qyugo/YVGESC/docs/hardware/README.md

---
title: Hardware Design
nav_order: 3
has_children: true
---

## Hardware Design

Here lies the documentation for the board design, including schematics, component datasheets, bill of materials, and the documentation of my design process.
