qyugo/YVGESC/docs/hardware/schematic.md

---
title: Schematics
parent: Hardware Design
nav_order: 2
---

# KiCad Schematic

---

YVGESC-1 was designed in KiCad.

<iframe src="https://qyugo.github.io/YVGESC/docs/images/yvgesc1-schematic2.pdf" width="100%" height="800px" style="border: none;"></iframe>

Click [here](https://qyugo.github.io/YVGESC/docs/images/yvgesc1-schematic2.pdf) to download as a PDF.

# PCB Routing

---

Here are some images of the PCB layout. Feel free to email me for more detailed views/project files.

<iframe src="https://qyugo.github.io/YVGESC/docs/images/pcbdesign.pdf" width="100%" height="800px" style="border: none;"></iframe>
