qyugo/YVGESC/firmware/yvgesc-1p0config.md

---
title: 1.0 Firmware Documentation
parent: Firmware
nav_order: 1
---

*UNDER CONSTRUCTION, Please come back later for updates and better organization. 10/14/26*

# Documentation for 0.0 Firmware to 1.0 Firmware

This documents the hardware, firmware, and software bring-up and testing process for developing all V0 versions up to V1.0, which is the first stable release.

## 1. Blink, Clock Config (V0.0)

1. Blink test on PB11 (33), toggle 2000ms

Configures PB11 (33) as blink GPIO for 0-3.3V oscillation of 2000ms, for verifying clock configuration. 

Initial testing firmware is configured in STM32CubeMX. STM32CubeMX was used to generate an STM32CubeIDE project for blink.

Here is a quick setup for flashing a 0-3.3v blink on the PB11 pin measured via oscilloscope.

From the Pinout and Configuration tab on the home page, switch to System View and configure the following:

SYS: Debug -> Serial Wire





The oscillator that this board uses is an Abracon AB8MG. From the Clock tab, set input frequency to 8MHz, and HSE at System Clock Mux and PLL Source Mux.



Timer toggle:





## 2. AS5047P Encoder

CubeMX was used to generate a CMake project for the rest of the v1p0 firmware.

The encoder is wired in at SPI2 (PB12, 13, 14, 25) for CSN, CLK, MOSI, and MISO

I wired PB14 to MOSI and PB15 to MISO mistakenly, so this will be changed if there is a V2 version of the board.

i. Instead of full duplex master, PB14->MOSI will need to be a permanently high GPIO and SPI2 will be configured in Half Duplex Master mode.

ii. Additionally, PB12 (ENC_CS) is set to HIGH GPIO. With NSS disabled, the pinout should show ENC_CS instead of SPI2_NSS.

iii. AS5047P encoders deliver 16 bits per frame and runs on a 2-Edge clock phase, so the setting must match accordingly.





SPI2 is effectively only configured to receive. The functions ```HAL_SPI_Transmit``` and ```HAL_SPI_TransmitReceive``` therefore, should never be called.

## 3. Gate Driver

1. DRV_Enable

The MCU on the YVGESC maps PC0 (8) to DRV_ENABLE. In Pinout view, this is set to GPIO output, ensuring output level: LOW in System Core -> GPIO.



2. DRV_nFAULT is set to PA6 in hardware, so it is configured to GPIO input in CubeMX:



This is where I encountered the first issue, as ADC was not properly reading the nFAULT signals. This is later fixed via hardware and in the 

Correction (unused): Led and fault, 100k resistor for v2

Notes: PA6 to ADC2_IN3 Watchdog
VREFINT Debug



SOC and Solder

VREF Soldered to 3.3V (issue 3, bringup for yvgesc v2)
SOC multimeter/scope checks

## 4. Current Sense







I had Vrefint wrongly configured. Update with CAL_ON = 1:



...and CAL_ON=0:



There is some noise, may try to reduce using oversampling later on, there is likely some noise nearby due to all the soldering or otherwise.

Current sense complete, next up will be the FDCAN and first PWM drive.

ADC and everything works. Released as 0.1.

## 5. FDCAN

PB8 is wired to CAN_RX, and PB9 is wired to CAN_TX, clocked to HSE @ 8MHz.



Test 1: internal loopback, 500kbits/s, sample point 87.5%



Will test Normal mode with another can bus to test for receiving messages as well as the termination switch.

## 6. PWM + Open Loop

Pinout:
INHA: PA8
INLA: PA7
INHB: PA9
INLB: PB0
INHC: PA10
INLC: PB1



Center aligned, 20kHz, 500ns dead time (currently x4)

Works.

CLock to PLL, 8-170MHz

pllm to /2



124ns tim1 dead time

SPi2 prescaler to 5.3125 mHZ

Open loop success. Released as 0.2.

## 7. Phase Current Sampling for FOC Loops

In this part, the sampling is configured to happen at a fixed point in each PWM cycle. The shunts are located on the low side FETs.

A PWM generation (No Output) channel is set for CH4, acting basically as a comparator:


VREF, initially part of the 4 injected channels, is now in the regular conversion channel. 



For the injected conversions, the sample is now performed on the falling edge of Timer 1 Trigger Out Event 2.

The interrupt line in USER CODE 4 is implemented as follows:

```
c
void HAL_ADCEx_InjectedConvCpltCallback(ADC_HandleTypeDef *h)
{
    if (h->Instance != ADC1) return;
    int32_t a = HAL_ADCEx_InjectedGetValue(h, ADC_INJECTED_RANK_1);
    int32_t b = HAL_ADCEx_InjectedGetValue(h, ADC_INJECTED_RANK_2);
    int32_t c = HAL_ADCEx_InjectedGetValue(h, ADC_INJECTED_RANK_3);
    so[0] = a; so[1] = b; so[2] = c;

    static int32_t sa, sb, sc, n;                 /* offset calibration */
    if (cal_req && !pwm_run) {
        sa += a; sb += b; sc += c;
        if (++n == 1024) {
            off[0] = sa / 1024; off[1] = sb / 1024; off[2] = sc / 1024;
            sa = sb = sc = n = 0; cal_req = 0;
        }
    }
    ia = (a - off[0]) * A_PER_COUNT;
    ib = (b - off[1]) * A_PER_COUNT;
    ic = (c - off[2]) * A_PER_COUNT;
    isum = ia + ib + ic;
    isr_cnt++;
}
```

Calibrating (cal_req=1, pwm_on=1, ol_mode=1, ol_v = 0.12



Current sums roughly 0:



Calibration with encoder adn offset:











ia, ib, ic are amps of the measured phase currents by the ADC via its $1 m\Omega$ shunt and multiplied by the gain of 40V/V.

Contextualization
Next, ia, ib, and ic are used in the Clarke transforms to become $I\alpha$ and $I\beta$, into a 2-part current descriptor in reference to the stator frame.

The park transform then converts $I\alpha$ and $I\beta$ into Iq and Id, in reference to the rotor axis.

The current loop then keeps Id at 0 and Iq relative to a torque command.

## 8. CURRENT LOOP - Running inside the ADC2 interrupt (20kHz)

What it does: measures current and transforms them into Id and Iq using encoder angle, with two PI controllers

New variables:
```
c
volatile uint32_t foc_mode = 0;          /* 1 = current loop drives the PWM */
volatile float id_ref = 0.0f, iq_ref = 0.0f;   /* commanded currents, A */
volatile float id, iq, vd, vq;           /* measured currents, output voltages */
volatile float kp = 0.3f;                /* V/A   (L × ωc, ωc = 2π·1 kHz) */
volatile float ki_ts = 0.03f;            /* V/A per sample (R × ωc × Ts) */
volatile float i_max = 2.0f;             /* command limit, A */
volatile float i_trip = 8.0f;            /* instant shutdown, A */
volatile uint32_t foc_fault = 0, isr_cycles = 0;
#define VBUS 12.0f
```

Interrupt callback:
```
c
void HAL_ADCEx_InjectedConvCpltCallback(ADC_HandleTypeDef *h)
{
    if (h->Instance != ADC1) return;
    uint32_t t0 = DWT->CYCCNT;

    /* --- currents --- */
    int32_t a = HAL_ADCEx_InjectedGetValue(h, ADC_INJECTED_RANK_1);
    int32_t b = HAL_ADCEx_InjectedGetValue(h, ADC_INJECTED_RANK_2);
    int32_t c = HAL_ADCEx_InjectedGetValue(h, ADC_INJECTED_RANK_3);
    so[0] = a; so[1] = b; so[2] = c;

    static int32_t sa, sb, sc, n;
    if (cal_req && pwm_run && ol_mode && !foc_mode && ol_v == 0.0f) {
        sa += a; sb += b; sc += c;
        if (++n == 1024) {
            off[0] = sa / 1024; off[1] = sb / 1024; off[2] = sc / 1024;
            sa = sb = sc = n = 0; cal_req = 0;
        }
    }
    ia = (a - off[0]) * A_PER_COUNT;
    ib = (b - off[1]) * A_PER_COUNT;
    ic = (c - off[2]) * A_PER_COUNT;
    isum = ia + ib + ic;

    /* --- encoder (moved here from the main loop) --- */
    raw = enc_frame();
    reads++;
    if (__builtin_parity(raw))      par_err++;
    else if (raw & 0x4000)          ef_cnt++;
    else                            ang = raw & 0x3FFF;
    float mech  = ang * (360.0f / 16384.0f);
    float raw_e = fmodf(mech * pole_pairs, 360.0f);
    if (align_req && pwm_run) { e_off = raw_e; align_req = 0; }
    e_deg = raw_e - e_off;
    if (e_deg < 0.0f) e_deg += 360.0f;

    /* --- hard overcurrent trip --- */
    if (fabsf(ia) > i_trip || fabsf(ib) > i_trip || fabsf(ic) > i_trip) {
        __HAL_TIM_MOE_DISABLE_UNCONDITIONALLY(&htim1);
        pwm_run = 0; foc_fault = 1;
    }

    /* --- current loop --- */
    static float id_int = 0.0f, iq_int = 0.0f;
    if (foc_mode && pwm_run) {
        float th = e_deg * 0.0174533f, s = sinf(th), co = cosf(th);

        float ial = ia;                              /* Clarke */
        float ibe = (ia + 2.0f * ib) * 0.57735f;
        id =  ial * co + ibe * s;                    /* Park */
        iq = -ial * s  + ibe * co;

        float idr = fminf(fmaxf(id_ref, -i_max), i_max);
        float iqr = fminf(fmaxf(iq_ref, -i_max), i_max);
        float vlim = 0.9f * VBUS * 0.57735f;

        float ed = idr - id, eq = iqr - iq;          /* PI */
        id_int = fminf(fmaxf(id_int + ki_ts * ed, -vlim), vlim);
        iq_int = fminf(fmaxf(iq_int + ki_ts * eq, -vlim), vlim);
        float vdd = kp * ed + id_int, vqq = kp * eq + iq_int;
        float vm = sqrtf(vdd * vdd + vqq * vqq);
        if (vm > vlim) { vdd *= vlim / vm; vqq *= vlim / vm; }
        vd = vdd; vq = vqq;

        float val = vdd * co - vqq * s;              /* inverse Park */
        float vbe = vdd * s  + vqq * co;
        float Va = val;                              /* inverse Clarke */
        float Vb = -0.5f * val + 0.866025f * vbe;
        float Vc = -0.5f * val - 0.866025f * vbe;
        float vo = 0.5f * (fmaxf(Va, fmaxf(Vb, Vc)) + fminf(Va, fminf(Vb, Vc)));

        uint32_t arr = __HAL_TIM_GET_AUTORELOAD(&htim1);
        float k = arr / VBUS, mid = arr * 0.5f;
        __HAL_TIM_SET_COMPARE(&htim1, TIM_CHANNEL_1, (uint32_t)(mid + (Va - vo) * k));
        __HAL_TIM_SET_COMPARE(&htim1, TIM_CHANNEL_2, (uint32_t)(mid + (Vb - vo) * k));
        __HAL_TIM_SET_COMPARE(&htim1, TIM_CHANNEL_3, (uint32_t)(mid + (Vc - vo) * k));
    } else {
        id_int = iq_int = 0.0f;                      /* reset when not running */
    }

    isr_cycles = DWT->CYCCNT - t0;
    isr_cnt++;
}
```

Testing order:
foc_mode = 0, ol_mode = 1, ol_v = 0, cal_req = 1, pwm_on = 1

ol_v = 0.15, ol_deg = 0, -> run -> align_req = 1

## 9. TORQUE MODE/closed loop current, and calibration script 

Minimum Iq = 2 to spin for Eaglepower

Torque mode / inner PI loops complete

Self note: kp = 0.3, ki = 0.03

FLASH update to store calibrations:
```c FLASH    (rx)    : ORIGIN = 0x8000000,   LENGTH = 126K ```

AFter good alignment: save_req = 1, save_res = 0 in debug

Works with flash calibration. If needed, realign and hit save_req=1, otherwise calibration should happen automatically upon boot.

## 10. VELOCITY CONTROL

Interrupt:
```
c
    /* --- multi-turn position + PLL speed estimate --- */
    const float TS = 50e-6f, CNT2RAD = 6.2831853f / 16384.0f;
    static int32_t last_ang = -1, pos_cnt = 0;
    static float pos_est = 0.0f, vel_est = 0.0f;
    if (last_ang < 0) { last_ang = ang; }
    int32_t dcnt = (int32_t)ang - last_ang;
    if (dcnt >  8192) dcnt -= 16384;
    if (dcnt < -8192) dcnt += 16384;
    last_ang = ang;
    pos_cnt += dcnt;
    float pos_meas = pos_cnt * CNT2RAD;

    float perr = pos_meas - pos_est;
    pos_est += TS * (vel_est + 2.0f * pll_bw * perr);
    vel_est += TS * (pll_bw * pll_bw * perr);
    pos = pos_meas;  vel = vel_est;  rpm = vel_est * 9.5493f;

    /* --- overspeed trip --- */
    if (pwm_run && fabsf(vel_est) > vel_trip) {
        __HAL_TIM_MOE_DISABLE_UNCONDITIONALLY(&htim1);
        pwm_run = 0; foc_fault = 2;
    }

    /* --- velocity loop -> iq command --- */
    static float vel_int = 0.0f;
    if (vel_mode && foc_mode && pwm_run) {
        float ve = vel_ref - vel_est;
        vel_int = fminf(fmaxf(vel_int + vel_ki * ve * TS, -i_max), i_max);
        iq_cmd  = fminf(fmaxf(vel_kp * ve + vel_int, -i_max), i_max);
    } else {
        vel_int = 0.0f;
        iq_cmd  = iq_ref;
    }
```
New fault label: foc_fault 2 = overspeed, foc_faul 1 = overcurrent

Kp 0.2, Ki 15

Some cogging stuff at lower speeds, bumped up ki, bumping up kp gives a grinding noise not from the motor.

Released as V0.4 in firmware.

## 11. Position and Impedance Control

```
c
else if (foc_mode && pwm_run && ctrl_mode == 2) {     /* impedance */
        vel_int = 0.0f;
        float tq = kp_p * (p_ref - p_rel) + kd_p * (v_ff - vel_est) + t_ff;
        torque_cmd = tq;
        iq_cmd = fminf(fmaxf(tq / kt, -i_max), i_max);
```

Objective: spring damper with feed forward torque t_ff.

Success.

TODO: User-friendly settings for stiff, medium, and loose compliance, as well as manual tuning via CAN.

## 12. CAN from another source/telemetry tests + YVGESC Control Software

Using first a CANable isolator to send telemtry directly from a PC, a python script was developed, which later was developed into the YVGESC UI. All debugging parameters, including zeroing, calibration, open loop controls, FOC controls, and tuning parameters were sent to the CAN bus in the callback section of the firmware. More details can be found in [CAN Setup](setups/CANSetup.md). 

Given at this point the firmware already runs a calibration script, the CAN python UI offers preprogrammed buttons that run times sequences for calibration, zeroing, and encoder alignment, in case things get messy during testing. At this point, the alignment occasionally falls, and will be debugged in later versions.

Further, as the software clears faults automatically if reset, an additional reset diagnosis from the previous fault is implemented.

```
c

//Private variable
volatile uint32_t rst_csr = 0;
// PV end

  /* USER CODE BEGIN 1 */

	rst_csr = RCC->CSR;
	   RCC->CSR |= RCC_CSR_RMVF;

  /* USER CODE END 1 */
/*USER CODE BEGIN 4 */
	/* 53 */ { &rst_csr, VT_U, 0 },
*/
```
In the software, fault causes are described in plain language in the UI.
```
python
def reset_cause(csr):
    flags = [(31, "low-power"), (30, "WWDG"), (29, "IWDG"), (28, "software"),
             (27, "brown-out"), (26, "reset pin"), (25, "option bytes")]
    hits = [n for b, n in flags if csr & (1 << b)]
    return ", ".join(hits) if hits else hex(csr)
```

At this point, most of my testing runs had a hard 10s limit. I'd still like to keep this limit on in the meantime for personal use, but I increased it to 60s for longer tests. An additional script to stop the board in 1s if the CAN cables happen to lose connection. 
Note* If in debugger mode, keepalive needs to be set to 0 since it's not in CAN mode.

```
c
volatile uint32_t last_param_ms = 0, keepalive = 1;

if (pwm_ms > 60000) pwm_ms = 60000;   /*60s limit*/

static void param_req(const uint8_t *d)
{
	last_param_ms = HAL_GetTick();
    FDCAN_TxHeaderTypeDef th = txh;
    th.Identifier = 0x580 + NODE_ID;
    th.DataLength = FDCAN_DLC_BYTES_8;

    uint8_t r[8] = { 0 };
    uint8_t op = d[0], idx = d[1];
    r[1] = idx;

/* CAN*/
      static uint32_t t_on = 0;
      static uint8_t was_can = 0;
      uint32_t lc = last_cmd_ms;
      if (can_en && (HAL_GetTick() - lc > 100)) {                 /* 100 ms timeout */
                can_en = 0; can_timeout_cnt++;
            }
      if (can_en) {
          pwm_run = foc_fault ? 0 : 1;                           /* CAN in control */
      } else {
          if (was_can) pwm_run = 0;                              /* CAN just stopped */
          if (pwm_on) { pwm_on = 0; if (!foc_fault) { pwm_run = 1; t_on = HAL_GetTick(); } }
          if (pwm_run && (HAL_GetTick() - t_on >= pwm_ms)) pwm_run = 0;
          uint32_t lp = last_param_ms;
          if (keepalive && pwm_run && (HAL_GetTick() - lp > 1000))
             pwm_run = 0;
      }
      was_can = can_en;
```
*AT THIS POINT, THE BOARD SHOULD STILL DRAW ~0.026A WHEN IDLE @ 12V.

*TODO:*
/---

## 13. DFU, BOOT0, and USB

## 14. USB SLCAN

## 15. Flux Braking (Advanced)
