qyugo/YVGESC/firmware/0p1-AS5047P-DRV-NFAULT-ADC/1p0doc.md

VERSION 1.0 FIRMWARE BRINGUP

1. AS5047 and PA13/14
2. nFAULT LED and debug



3. ADC2, ADC unpowered
4. Success
