qyugo/YVGESC/docs/images/ignore-componentimages.md

IGNORE - For Docs page formatting

### Wurth 7447779147 $47\mu H$ Power Inductor: [Datasheet](https://www.we-online.com/components/products/datasheet/7447715470.pdf)



### Infineon BSC057N08NS3G 80V N-Ch MOSFET: [Datasheet](https://www.infineon.com/assets/row/public/documents/24/49/infineon-bsc057n08ns3-g-datasheet-en.pdf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)



### PESD1CAN (CAN bus ESD Protection Diode): [Datasheet](https://assets.nexperia.com/documents/data-sheet/PESD1CAN.pdf)



### TCAN33x (CAN Transceiver): [Datasheet](https://www.ti.com/lit/ds/symlink/tcan332.pdf?ts=1709051257834)



### LM5164 (Synchronous Buck Converter): [Datasheet](https://www.ti.com/lit/ds/symlink/lm5164.pdf)



### TI DRV8323x Gate Driver: [Datasheet](https://www.ti.com/lit/ds/symlink/drv8323.pdf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)



### STM32G431RBT6 Microcontroller Unit: [Datasheet](https://www.st.com/resource/en/datasheet/stm32g431c6.pdf)



### ST USBLC6 Datasheet:[Datasheet](https://www.st.com/resource/en/datasheet/usblc6-2.pdf)



### Vishay Dale 1mΩ Shunt Resistors: [Datasheet](https://www.vishay.com/docs/30108/wsk2512.pdf)



### Megastar Dip Switch: [Datasheet](https://www.lcsc.com/datasheet/C7527760.pdf)
Screenshot 2026-09-29 at 10 29 40 PM

### ABM8G Resonator: [Datasheet](https://abracon.com/Resonators/ABM8G.pdf)



### AS5047P Encoder: [Datasheet](https://look.ams-osram.com/m/d05ee39221f9857/original/AS5047P-DS000324.pdf)
