qyugo/YVGESC/docs/images/pcbdesign.pdf

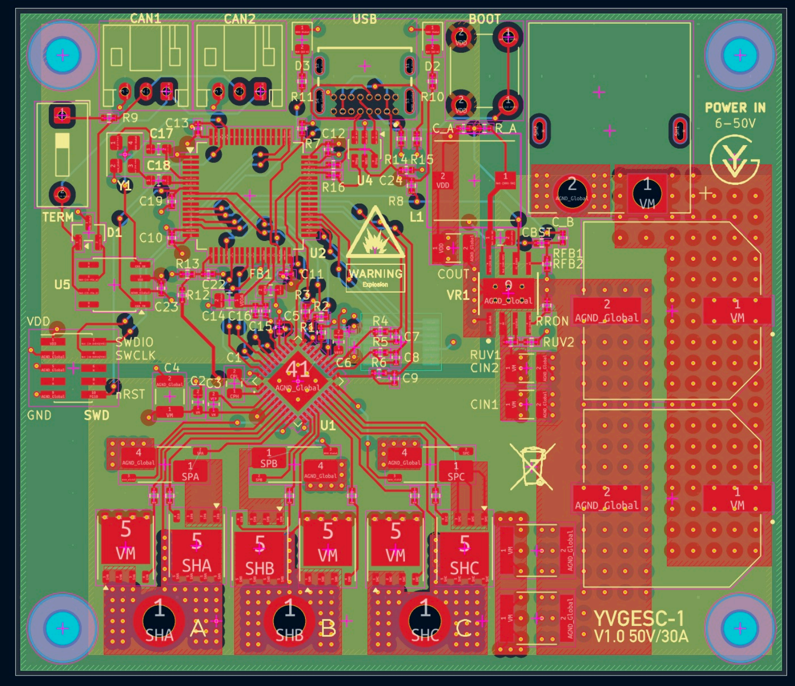
[picture p12: page 1]
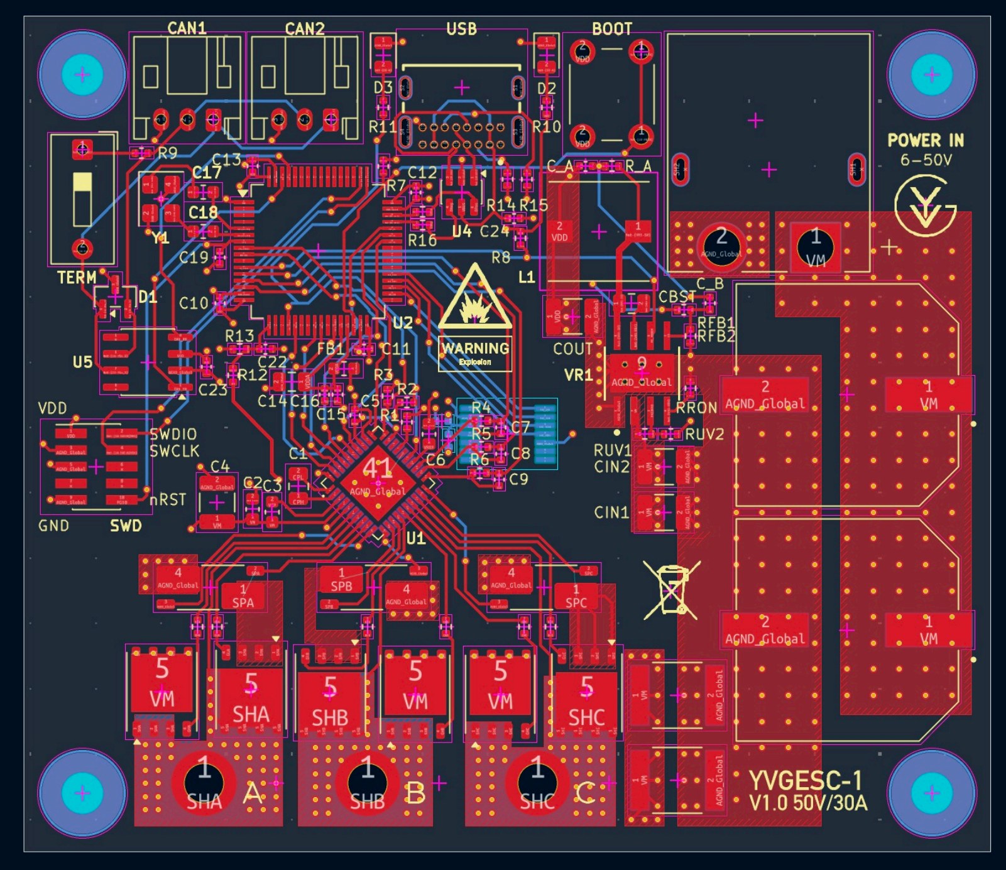
[picture p13: page 2]
