qyugo/YVGESC/docs/images/pcb_render_front.pdf

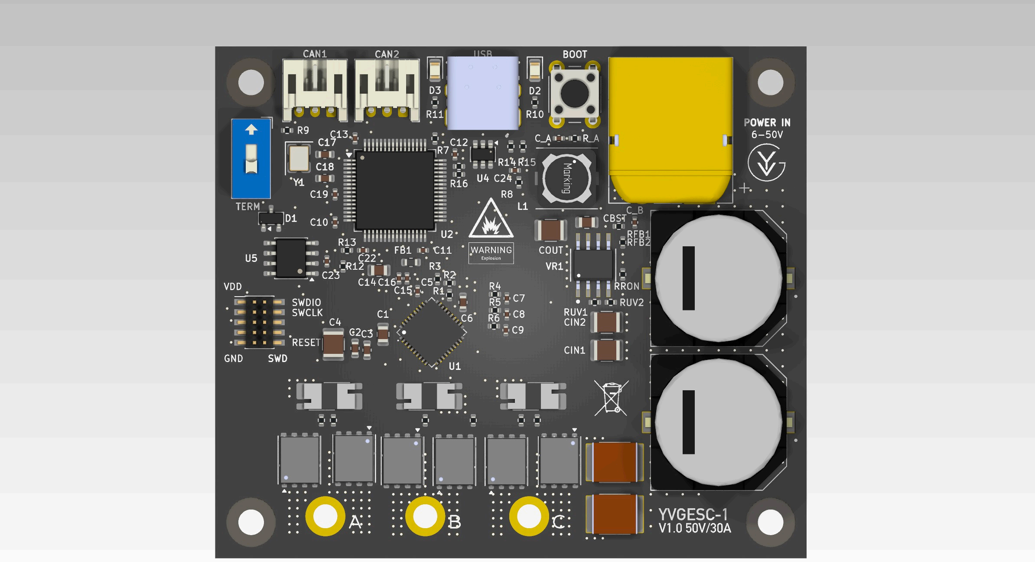
[picture p14: page 1]
