qyugo/YVGESC/docs/hardware/bom.md

---
title: Bill of Materials
parent: Hardware Design
nav_order: 3
---

# Bill of Materials

<iframe src="https://view.officeapps.live.com/op/embed.aspx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"
        width="100%" height="600px" style="border: none;"></iframe>
