qyugo/YVGESC/docs/electricalcomponents-bom.xlsx

YVGESC-1 Electrical Components BOM
Component | Cost | Units Sold | Units Needed | Cost of Needed Units
Gate Driver / TI DRV8323HRTAR (6-60V) LCSC (https://www.lcsc.com/product-detail/C701783.html?s_z=n_q_drv8323h) | 7.51 | 5 | 5 | 7.51
Microcontroller / STMicroelectronics STM32G431RBT6 (170MHz) Mouser (https://www.mouser.com/en/ProductDetail/STMicroelectronics/STM32G431RBT6?qs=T3oQrply3y8GpSwPjv1GMg%3D%3D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) | 14.16 | 5 | 5 | 14.16
Encoder / AMS AS5047P-ATSM (4.5-5.5V, 15mA) LCSC (https://www.lcsc.com/product-detail/C962063.html) | 14.26 | 5 | 5 | 14.26
ESD Protection Diode / STMicroelectronics USBLC6-2SC6 (17V Clamp/5A) LCSC (https://www.lcsc.com/product-detail/C7519.html?s_z=n_q_USBLC6-2SC6) | 1.28 | 7 | 5 | 0.91
CAN-FD Transceiver / TCAN332GDR SOIC8 (3-3.6V/5Mbps) LCSC (https://www.lcsc.com/product-detail/C191010.html?s_z=n_q_tcan332) | 8.68 | 5 | 5 | 8.68
C1 / TDK C2012X7R2A473KT0L0U X7R (47nF ±10%, 100V) LCSC (https://www.lcsc.com/product-detail/C342507.html?s_z=n_q_t_capacitor) | 0.49 | 13 | 5 | 0.19
C2 / muRata GCM188R72A104KA64D (0.1µF ±10%, 100V) LCSC (https://www.lcsc.com/product-detail/C415406.html?s_z=n_q_GCM188R72A104KA64D) | 0.9 | 9 | 5 | 0.5
C3 / Samsung CL10B105KA8NNNC X7R (1µF ±10%, 25V) LCSC (https://www.lcsc.com/product-detail/C29936.html?s_z=n_q_CL10B105KA8NNNC) | 0.43 | 20 | 5 | 0.11
C4 / PSA FS32X106K101EGG X7R (10µF ±10%, 100V)LCSC (https://www.lcsc.com/product-detail/C5156756.html?s_z=n_q_t_capacitor) | 2.48 | 5 | 5 | 2.48
C5, C15, C20 / muRata GRM155Z71A105KE01D X7R (1µF ±10% / 10V) LCSC (https://www.lcsc.com/product-detail/C528974.html?s_z=n_q_GRM155Z71A105KE01D) | 0.68 | 23 | 15 | 0.44
C6 / YAGEO CC0603KRX7R7BB104 X7R (100nF ±10%, 16V) LCSC (https://www.lcsc.com/product-detail/C108079.html?s_z=n_q_CC0603KRX7R7BB104) | 0.06 | 20 | 5 | 0.02
C7,8,9 / YAGEO CC0402KRX7R9BB222 X7R (2200pF ±10%, 50V) LCSC (https://www.lcsc.com/product-detail/C106861.html?s_z=n_q_YAGEO%2520CC0402KRX7R9BB222) | 0.08 | 25 | 15 | 0.05
C10-13, 16, 19,21,23,24 / muRata GCM155R71A104KA55D X7R (100nF ±10% 10V) LCSC (https://www.lcsc.com/product-detail/C161163.html?s_z=n_q_GCM155R71A104KA55D) | 1.37 | 70 | 45 | 0.88
C14 / Yageo CC0805KKX7R7BB475 X7R (4.7 µF ±10% 16V) LCSC (https://www.lcsc.com/product-detail/C277499.html?s_z=n_q_CC0805KKX7R7BB475) | 0.23 | 9 | 5 | 0.13
C17, C18 / Samsung CL10C270JB8NNNC (26pF ±5% 50V) LCSC (https://www.lcsc.com/product-detail/C1656.html?s_z=n_q_CL10C270JB8NNNC) | 0.19 | 20 | 10 | 0.1
C22 / CCTC TCC0402X7R472K500AT X7R (4.7nF ±10%, 25V) LCSC (https://www.lcsc.com/product-detail/C696917.html?s_z=n_q_TCC0402X7R472K500AT) | 0.06 | 20 | 5 | 0.015
CA / Samsung CL05C102JB5NNNC (1nF ±5% / 50V) LCSC (https://www.lcsc.com/product-detail/C307441.html?s_z=n_q_t_capacitor) | 0.19 | 20 | 5 | 0.05
CB / YAGEO CC0402JRNPO9BN271 (270pF ±5% / 50V) LCSC (https://www.lcsc.com/product-detail/C107003.html?s_z=n_q_t_capacitor) | 0.11 | 20 | 5 | 0.03
Bootstrap Capacitor / Samsung CL21C222JBFNNNE (2.2nF / 50V ±5%) LCSC (https://www.lcsc.com/product-detail/C28260.html?s_z=n_q_t_capacitor) | 0.29 | 9 | 5 | 0.16
VReg Input Capacitor (x2) / PSA FS32X225K101EGG (2.2µF / 100V ±10%) LCSC (https://www.lcsc.com/product-detail/C153036.html?s_z=n_q_t_capacitor) | 1.83 | 14 | 10 | 1.31
VReg Output Capacitor / SAMWHA CS3225X7R226K250NRL (22μF / 25V ±10%) LCSC (https://www.lcsc.com/product-detail/C2918511.html?s_z=n_q_t_capacitor) | 0.36 | 9 | 5 | 0.2
CAN TVS Diode / Nexperia PESD1CAN-215 (24VWRM / 40Vc) LCSC (https://www.lcsc.com/product-detail/C15771.html?s_z=n_q_PESD1CAN) | 0.63 | 9 | 5 | 0.35
Green LED / Hubei KENTO Elec KT-0805G LCSC (https://www.lcsc.com/product-detail/C2297.html?s_z=n_q_C2297&globalKeyword=C2297) | 0.24 | 20 | 5 | 0.05
Red LED / Hubei KENTO Elec KT-0805R (0805/2012)LCSC (https://www.lcsc.com/product-detail/C2295.html?s_z=n_q_c2295&globalKeyword=c2295) | 0.17 | 20 | 5 | 0.03
Ferrite Bead / muRata BLM18AG601SN1D (600Ω @ 100MHz) LCSC (https://www.lcsc.com/product-detail/C19330.html?s_z=n_q_BLM18AG601SN1D) | 0.29 | 20 | 5 | 0.07
R1 / FOJAN FRC0402F7502TS (75kΩ ±0.1%) YAGEO RT0402BRD0775KL C728563 LCSC (https://www.lcsc.com/product-detail/C728563.html?s_z=n_q_t_resistor) | 0.59 | 20 | 5 | 0.15
R2, 3, 7, 13, 14, 15 / FOJAN FRC0402F5101TS (5.1kΩ ±1%) LCSC (https://www.lcsc.com/product-detail/C2906874.html?s_z=n_q_t_resistor) | 0.08 | 40 | 30 | 0.06
R4, R5, R6 / YAGEO AC0402FR-07100RL (100Ω ±1%) LCSC (https://www.lcsc.com/product-detail/C144808.html?s_z=n_q_t_resistor) | 0.03 | 25 | 15 | 0.02
PGood Pull-up Resistor / Walsin WR04X473JTL (47k ±5%) LCSC (https://www.lcsc.com/product-detail/C384326.html?s_z=n_q_t_resistor) | 0.04 | 20 | 5 | 0.01
R9 (CAN Resistor) / FOJAN FRC0402J121 TS (120Ω ±5%) LCSC (https://www.lcsc.com/product-detail/C2906888.html?s_z=n_q_t_resistor) | 0.04 | 20 | 5 | 0.01
GLED Resistor / HWA CHN HRC0402F82R0DNTO (82Ω ±1%) LCSC RC0402FR-0782RL #:C163453 update cicada bom (https://www.lcsc.com/product-detail/C54920707.html?s_z=n_q_t_resistor) | 0.02 | 20 | 5 | 0.005
RLED Resistor / VISHAY CRCW0402180RFKEDC (180Ω, ±1%) LCSC (https://www.lcsc.com/product-detail/C2076590.html?s_z=n_q_t_resistor) | 0.14 | 0.2 | 5 | 0.035
R12, RFB1 / FOJAN FRC0402F1003TS (100kΩ ±1%) LCSC (https://www.lcsc.com/product-detail/C2906859.html?s_z=n_q_t_resistor) | 0.01 | 20 | 10 | 0.005
R16, R17 / FOJAN FRC0402F22R0TS (22Ω ±1%) LCSC (https://www.lcsc.com/product-detail/C2929994.html?s_z=n_q_t_resistor) | 0.04 | 20 | 10 | 0.02
RA / Walsin WR04X4533FTL (453kΩ ±1%) LCSC (https://www.lcsc.com/product-detail/C170322.html?s_z=n_q_t_resistor) | 0.04 | 20 | 5 | 0.01
RFB2 / FOJAN FRC0402F5762TS (57.6kΩ ±1%) LCSC (https://www.lcsc.com/product-detail/C2960799.html?s_z=n_q_t_resistor) | 0.04 | 20 | 5 | 0.01
R_RON / CHANGLONG CL0402FN27K4P (27.4kΩ ±1%) LCSC (https://www.lcsc.com/product-detail/C48996775.html?s_z=n_q_t_resistor) | 0.02 | 20 | 10 | 0.01
Gate Resistors (x6) / FOJAN FRC0402F3R30TS (3.3Ω ±1% 62.5mW) LCSC (https://www.lcsc.com/product-detail/C2933094.html?s_z=n_q_t_resistor) | 0.09 | 40 | 30 | 0.07
RUV1 / FOJAN FRC0402F4302TS (43kΩ ±1%, 62.5mW 50V) LCSC (https://www.lcsc.com/product-detail/C2909359.html?s_z=n_q_t_resistor) | 0.05 | 20 | 5 | 0.01
RUV2 / VISHAY CRCW040210K0FKED (10kΩ ±1% 63mW 50V) LCSC (https://www.lcsc.com/product-detail/C71617.html?s_z=n_q_t_resistor) | 0.08 | 20 | 5 | 0.02
Current Sensing Shunt Resistors (3x) / Vishay Dale WSK25121L000FEA (1mΩ, ±1%, 1W) Mouser (https://www.mouser.com/en/ProductDetail/Vishay-Dale/WSK25121L000FEA?qs=fncU5wK7Cm%2F1m%252BfswX3oww%3D%3D) | 37.62 | 15 | 15 | 37.62
N-Channel MOSFETs / Infineon BSC057N08NS3GATMA1 (VDS = 80V) DigiKey (https://www.digikey.com/en/products/detail/infineon-technologies/BSC057N08NS3GATMA1/2080628) | 65.74 | 30 | 30 | 65.74
Bulk Electrolytic Capacitors (x2) / Panasonic EEE-TKK221UAM (220 µF ±20% / 80V) DigiKey (https://www.digikey.com/en/products/detail/panasonic-industry/EEE-TKK221UAM/1975569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) | 31.81 | 10 | 10 | 31.81
Bulk MLCC Capacitors (x2) / TDK CGA9N2X7R2A475K230KA DigiKey (4.7 µF ±10% 100V) (https://www.digikey.com/en/products/detail/tdk-corporation/CGA9N2X7R2A475K230KA/2781366) | 25.11 | 10 | 10 | 25.11
Power Inductor / Würth Elektronik 7447779147 (47μH) DigiKey (https://www.digikey.com/en/products/detail/w%C3%BCrth-elektronik/7447779147/9676096) | 16.92 | 5 | 5 | 16.92
Serial Wire Debug / Samtec FTSH-105-01-F-DV-K LCSC (https://www.lcsc.com/product-detail/C5382952.html?s_z=n_q_FTSH-105-01-F-DV-K) | 7.48 | 5 | 5 | 7.48
XT60 Connector LCSC (https://www.lcsc.com/product-detail/C98732.html?s_z=s_p_XT60PW-M) | 3 | 5 | 5 | 3
JST 3-pin CAN Terminals (x2) / JST S3B-PH-K-S LCSC (https://www.lcsc.com/product-detail/C157929.html?s_z=n_q_JST%2520S3B-PH-K-S) | 0.41 | 11 | 10 | 0.41
USB-C / GCT USB4085-GF-A LCSC (https://www.lcsc.com/product-detail/C7095263.html?s_z=n_q_C7095263&globalKeyword=C7095263) | 7.03 | 5 | 5 | 7.03
Quartz Oscillator / Abcracon ABM8AIG-8.000MHZ-1Z-T (8MHz) LCSC (https://www.lcsc.com/product-detail/C5140594.html?s_z=n_q_ABM8AIG-8.000MHZ-1Z-T%2520) | 5.35 | 5 | 5 | 5.35
Buck Regulator / TI LM5164DDAT(6-100V / 1A) LCSC (https://www.lcsc.com/product-detail/C2071198.html?s_z=n_q_LM5164DDAT) | 10.25 | 5 | 5 | 10.25
BOOT button / SHOU HAN SH-6X6X4.3H-CJ LCSC (https://www.lcsc.com/product-detail/C42416242.html) | 0.11 | 5 | 5 | 0.11
CAN Termination DIP Switch /Megastar ZX-2.54BM-1PZC 1-Pos SPST P = 2.54mm LCSC (https://www.lcsc.com/product-detail/C7527760.html?s_z=n_q_1%2520position%2520dip%2520switch) | 1.22 | 5 | 5 | 1.22
Final Costs | USD
Total Spend on Parts | 270.33
Parts Cost for 5 Boards | 265.18
Parts Cost Per Board | 53.036
