qyugo/YVGESC/docs/instructions/README.md

---
title: Instructions
nav_order: 2
has_children: true
---

## Setup Instructions - YVGESC-1

Here lies the instructions for setting up hardware and firmware for use.

Read the [Electrical Setup](Electrical-Setup.md) for necessary/optional additional hardware for flashing, comms, power, and safety practices.

Read the [Mechanical Setup](Mechanical-Setup.md) for mounting the PCB to your motor, as well as lining up a magnet for the onboard encoder.

Read the [Firmware Setup](Firmware-Setup.md) for initial flashing and downloading firmware.

<div style="position: relative; padding-bottom: 56.25%; height: 0; overflow: hidden; max-width: 100%;">
  <iframe
    src="https://www.youtube.com/embed/S9OsQaVYzI0"
    style="position: absolute; top: 0; left: 0; width: 100%; height: 100%; border: 0;"
    title="foc on custom board"
    loading="lazy"
    allow="accelerometer; autoplay; clipboard-write; encrypted-media; gyroscope; picture-in-picture; web-share"
    allowfullscreen>
  </iframe>
</div>
