qyugo/YVGESC/firmware/setups/CANSetup.md

---
title: CAN Setup + GUI
nav_order: 6
has_children: true
---

# CAN Setup + Python UI

In the V0 firmware, only internal loopback was configured for CAN. 
V1 firmware requires a CAN adaptor as USB->SLCAN had not been configured, but should work without the setup steps.

Check the instructions for the UI usage and variable nomenclature [here](YVGUIinstructions.md), as V1 directly references the debug variables.

[Download V1 firmware](../1p0)
<br>
[Download CAN UI](YVCAN1p0.py)

<iframe
  src="https://www.youtube.com/embed/SErpxAt9m6E"
  style="width:100%; aspect-ratio:16/9; border:0;"
  title="CAN setup"
  loading="lazy"
  allowfullscreen>
</iframe>



Here, CAN was configured to send parameters and telemetry from both a computer using a CANAble and through another board. If only using two nodes (one sender, one receiver), the $120\Omega$ switch should be turned ON on both sides. Therefore, the resistance from CANH to CANL should be $60\Omega$.

## Setup Documentation

1. USB to CAN Adapter

Screenshot 2026-10-07 at 7 29 55 PM

CANH Pin 1, CANL Pin 2

Screenshot 2026-10-07 at 7 30 58 PM

For my connectors, yellow is CANH, black is CANL, red is GND.




In NVIC, interrupt priority is set to ADC before FDCAN1:
