qyugo/YVGESC/docs/testing/tests.md

---
title: Board Testing (In progress)
nav_order: 7
has_children: true
---

*Under construction*

Testing protocols will resume for the board soon. The current plan is to test higher power, with a LiPo battery, safety trips, and thermal/emissions characteristics.

Will include a formal testing proposal and writeups once complete.

# Thermal Analysis

Preview with small thermal camera:

<video src="https://github.com/user-attachments/assets/9f1ebe8e-2e1a-4b53-bdbc-944cb2eb0693" autoplay loop muted playsinline style="width: 100%;"></video>

# Emissions Test

I have a TinySA spectrum analyzer, in which I will have to figure out how to test board emissions from.

IMG_4477 Large
