qyugo/YVGESC/firmware/1p0/Core/Src/main.c

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
/* Includes ------------------------------------------------------------------*/
#include "main.h"

/* USER CODE BEGIN Includes */

#include <math.h>
#include <string.h>

/* USER CODE END Includes */

ADC_HandleTypeDef hadc1;
ADC_HandleTypeDef hadc2;

FDCAN_HandleTypeDef hfdcan1;

SPI_HandleTypeDef hspi2;

TIM_HandleTypeDef htim1;

/* USER CODE BEGIN PV */

volatile uint32_t rst = 0; //reset cue
volatile uint32_t pwm_ms = 5000;  //pwm timeout

volatile float pole_pairs = 20.0f; // pole pairs

volatile uint32_t pwm_run = 0;

volatile uint32_t ol_mode = 0;    /* 1 = open-loop */
volatile float ol_amp  = 0.0f;    /* vector amplitude (0.4 A per count) */
volatile float ol_deg  = 0.0f;    /* electrical angle, degrees */
volatile float ol_rate = 0.0f;    /* degrees added per loop (~1 ms) */
volatile float ol_v = 0.0f;        /* vector amplitude in volts , ~0.1 V = 1 A */

//encoder
volatile uint16_t raw, ang, amin = 0xFFFF, amax = 0;
volatile uint32_t par_err = 0, ef_cnt = 0, reads = 0;
volatile uint32_t drv_on = 1;

volatile uint32_t ang32 = 0;

//adc
volatile uint32_t nf_adc;
volatile uint32_t adc_st;
volatile uint32_t vref_adc, vref_st, vdda_mv;

//sense outputs
volatile uint16_t so[3], so_min[3] = {4095,4095,4095}, so_max[3] = {0,0,0};
volatile uint16_t vr_min = 4095, vr_max = 0;
volatile uint32_t cal_on = 0;

//CAN
FDCAN_TxHeaderTypeDef txh;
FDCAN_RxHeaderTypeDef rxh;
uint8_t txd[8], rxd[8];
volatile uint32_t can_tx = 0, can_rx = 0, can_txerr = 0, can_rxid = 0;
volatile uint32_t can_tec = 0, can_rec = 0, can_busoff = 0;

//PWM
volatile uint32_t pwm_on = 0; /* true starting condition */
volatile uint32_t duty[3] = {0, 0, 0};     /* percent A,B,C */

//encoder alignment
volatile int32_t  off[3] = {2048, 2048, 2048};   /* zero current offsets */
volatile float    ia, ib, ic, isum;              /* phase currents, amps */
volatile uint32_t isr_cnt = 0, cal_req = 1;

#define A_PER_COUNT  (3.3f / 4095.0f / (40.0f * 0.001f))   /* ~0.0201 A/count */

volatile float    e_deg;            /* electrical angle from encoder, degrees */
volatile float    e_off = 0.0f;     /* alignment offset, degrees */
volatile uint32_t align_req = 0;    /* Alignment request between e_deg and ol_deg */

//foc
volatile uint32_t foc_mode = 0;          /* Foc mode: current PI loop drives pwm  */
volatile float id_ref = 0.0f, iq_ref = 0.0f;   /* commanded current (A) */
volatile float id, iq, vd, vq;           /* measured current and voltage in d/q */
volatile float kp = 0.3f;                /* TORQUE MODE Kp V/A   (L × ωc, ωc = 2π·1 kHz) */
volatile float ki_ts = 0.03f;            /* TORQUE MODE Ki V/A (R × ωc × Ts) */
volatile float i_max = 2.0f;             // A
volatile float i_trip = 8.0f;            // A
volatile uint32_t foc_fault = 0, isr_cycles = 0;
#define VBUS 12.0f

volatile float e_err;

//FLASH

#define CAL_ADDR  0x0801F800UL
#define CAL_PAGE  63
#define CAL_MAGIC 0xCA1B0001UL
typedef struct __attribute__((aligned(8))) {
    uint32_t magic, ver;
    float    e_off, pole_pairs;
    uint32_t sum, pad;
} cal_t;
volatile uint32_t save_req = 0, cal_ok = 0;
volatile int32_t  save_res = 0;

//velocity

volatile float vel_ref  = 0.0f;      // commanded speed, rad/s (mechanical)
volatile float vel      = 0.0f;      // estimated speed, rad/s
volatile float rpm      = 0.0f;      // same, in RPM, for viewing
volatile float pos      = 0.0f;      // multi-turn position, rad
volatile float vel_kp   = 0.05f;     // Velocity kp , A per rad/s
volatile float vel_ki   = 0.5f;      // Velocity ki , A per rad
volatile float pll_bw   = 1000.0f;   // speed estimator bandwidth, rad/s
volatile float vel_trip = 150.0f;    // overspeed trip, rad/s (150 = 1430 RPM)
volatile float iq_cmd   = 0.0f;      // current loop command (A) (Reading, not a setting)

//position/impedance
volatile uint32_t ctrl_mode = 0;   // 0 = torque mode/iq_ref, 1 = velocity/vref, 2 = position/impedance posref,ff
volatile float p_ref  = 0.0f;      /* target motor position, rad*/
volatile float v_ff   = 0.0f;      /* target velocity, rad/s */
volatile float t_ff   = 0.0f;      /* feed-forward torque, N·m */
volatile float kp_p   = 0.1f;      /* Position Kp, Nm per rad */
volatile float kd_p   = 0.002f;    /* Position kd, Nm per (rad/s) */
volatile float kt     = 0.08f;     /* Nm per A */
volatile float p_rel  = 0.0f;      /* rad */
volatile float pos_zero = 0.0f, torque_cmd = 0.0f;
volatile uint32_t zero_req = 0;

//CAN
#define NODE_ID 1
#define P_MAX 12.5f
#define V_MAX 100.0f
#define KP_MAX 5.0f
#define KD_MAX 0.1f
#define T_MAX 1.0f
volatile uint32_t can_en = 0, can_cmd_cnt = 0, can_timeout_cnt = 0, last_cmd_ms = 0;

volatile uint32_t rst_csr = 0;
volatile uint32_t last_param_ms = 0, keepalive = 1;

/* USER CODE END PV */

void SystemClock_Config(void);
static void MX_GPIO_Init(void);
static void MX_SPI2_Init(void);
static void MX_ADC2_Init(void);
static void MX_ADC1_Init(void);
static void MX_FDCAN1_Init(void);
static void MX_TIM1_Init(void);
/* USER CODE BEGIN 0 */

static uint32_t cal_sum(const cal_t *c) {
    const uint32_t *p = (const uint32_t *)c;
    return p[0] + p[1] + p[2] + p[3] + 0x5A5A5A5AUL;
}
static int cal_load(void) {
    const cal_t *c = (const cal_t *)CAL_ADDR;
    if (c->magic != CAL_MAGIC || c->sum != cal_sum(c)) return 0;
    e_off = c->e_off;  pole_pairs = c->pole_pairs;
    return 1;
}
static int32_t cal_save(void) {
    if (pwm_run) return -1;
    cal_t c = { CAL_MAGIC, 1, e_off, pole_pairs, 0, 0 };
    c.sum = cal_sum(&c);
    HAL_FLASH_Unlock();
    __HAL_FLASH_CLEAR_FLAG(FLASH_FLAG_ALL_ERRORS);
    FLASH_EraseInitTypeDef er = { .TypeErase = FLASH_TYPEERASE_PAGES,
                                  .Banks = FLASH_BANK_1, .Page = CAL_PAGE, .NbPages = 1 };
    uint32_t perr;
    if (HAL_FLASHEx_Erase(&er, &perr) != HAL_OK) { HAL_FLASH_Lock(); return -2; }
    const uint64_t *d = (const uint64_t *)&c;
    for (uint32_t i = 0; i < sizeof(c) / 8; i++)
        if (HAL_FLASH_Program(FLASH_TYPEPROGRAM_DOUBLEWORD, CAL_ADDR + 8 * i, d[i]) != HAL_OK)
            { HAL_FLASH_Lock(); return -3; }
    HAL_FLASH_Lock();
    return cal_load() ? 0 : -4;
}

static uint16_t enc_frame(void)
{
    uint16_t rx = 0;
    HAL_GPIO_WritePin(ENC_CS_GPIO_Port, ENC_CS_Pin, GPIO_PIN_RESET);
    HAL_SPI_Receive(&hspi2, (uint8_t *)&rx, 1, 10);   /* receive only, no transmit */
    HAL_GPIO_WritePin(ENC_CS_GPIO_Port, ENC_CS_Pin, GPIO_PIN_SET);
    return rx;
}

//can packing
static uint32_t f2u(float x, float lo, float hi, int bits) {
    if (x < lo) x = lo;
    if (x > hi) x = hi;
    return (uint32_t)((x - lo) * (float)((1u << bits) - 1) / (hi - lo));
}
static float u2f(uint32_t u, float lo, float hi, int bits) {
    return (float)u * (hi - lo) / (float)((1u << bits) - 1) + lo;
}



/* USER CODE END 0 */

/**
  * @brief  The application entry point.
  * @retval int
  */
int main(void)
{

  /* USER CODE BEGIN 1 */

	rst_csr = RCC->CSR;
	   RCC->CSR |= RCC_CSR_RMVF;

  /* USER CODE END 1 */

  /* MCU Configuration--------------------------------------------------------*/

  /* Reset of all peripherals, Initializes the Flash interface and the Systick. */
  HAL_Init();

  /* Configure the system clock */
  SystemClock_Config();

  /* Initialize all configured peripherals */
  MX_GPIO_Init();
  MX_SPI2_Init();
  MX_ADC2_Init();
  MX_ADC1_Init();
  MX_FDCAN1_Init();
  MX_TIM1_Init();
  /* USER CODE BEGIN 2 */

  CoreDebug->DEMCR |= CoreDebug_DEMCR_TRCENA_Msk;
  DWT->CYCCNT = 0;
  DWT->CTRL |= DWT_CTRL_CYCCNTENA_Msk;

  HAL_Delay(10);
  HAL_ADCEx_Calibration_Start(&hadc2, ADC_SINGLE_ENDED);
  HAL_ADCEx_Calibration_Start(&hadc1, ADC_SINGLE_ENDED);

  HAL_FDCAN_ConfigGlobalFilter(&hfdcan1, FDCAN_ACCEPT_IN_RX_FIFO0,
                               FDCAN_REJECT, FDCAN_FILTER_REMOTE, FDCAN_FILTER_REMOTE);
  HAL_FDCAN_ActivateNotification(&hfdcan1, FDCAN_IT_RX_FIFO0_NEW_MESSAGE, 0);
  HAL_FDCAN_Start(&hfdcan1);

  txh.Identifier          = 0x123;
  txh.IdType              = FDCAN_STANDARD_ID;
  txh.TxFrameType         = FDCAN_DATA_FRAME;
  txh.DataLength          = FDCAN_DLC_BYTES_8;
  txh.ErrorStateIndicator = FDCAN_ESI_ACTIVE;
  txh.BitRateSwitch       = FDCAN_BRS_OFF;
  txh.FDFormat            = FDCAN_CLASSIC_CAN;
  txh.TxEventFifoControl  = FDCAN_NO_TX_EVENTS;
  txh.MessageMarker       = 0;

  __HAL_DBGMCU_FREEZE_TIM1(); /* stop TIM1 when debugger pauses */
  HAL_TIM_PWM_Start(&htim1, TIM_CHANNEL_1);  HAL_TIMEx_PWMN_Start(&htim1, TIM_CHANNEL_1);
  HAL_TIM_PWM_Start(&htim1, TIM_CHANNEL_2);  HAL_TIMEx_PWMN_Start(&htim1, TIM_CHANNEL_2);
  HAL_TIM_PWM_Start(&htim1, TIM_CHANNEL_3);  HAL_TIMEx_PWMN_Start(&htim1, TIM_CHANNEL_3);
  __HAL_TIM_MOE_DISABLE_UNCONDITIONALLY(&htim1);

  HAL_TIM_PWM_Start(&htim1, TIM_CHANNEL_4); /* internal ADC trigger */
  HAL_ADCEx_InjectedStart_IT(&hadc1);



  //HAL_GPIO_WritePin(DRV_EN_GPIO_Port, DRV_EN_Pin, GPIO_PIN_SET);
  HAL_Delay(2);

  cal_ok = cal_load(); // restore e_off and pole_pairs
  foc_mode = 0; ol_mode = 1; ol_v = 0.0f; //foc and open loop mode settings
  foc_fault = 0;

  /* USER CODE END 2 */

  /* Infinite loop */
  /* USER CODE BEGIN WHILE */
  while (1)
    {
    /* USER CODE END WHILE */

    /* USER CODE BEGIN 3 */

	  //calibration save
      if (save_req && !pwm_run) { save_res = cal_save(); save_req = 0; }

      if (rst) {
          rst = 0;
          for (int i = 0; i < 3; i++) { so_min[i] = 4095; so_max[i] = 0; }
          amin = 0xFFFF; amax = 0;
          vr_min = 4095; vr_max = 0;
      }
      /* drv8323h */
      HAL_GPIO_WritePin(DRV_EN_GPIO_Port, DRV_EN_Pin,
                        drv_on ? GPIO_PIN_SET : GPIO_PIN_RESET);
      HAL_GPIO_WritePin(DRV_CAL_GPIO_Port, DRV_CAL_Pin,
                        cal_on ? GPIO_PIN_SET : GPIO_PIN_RESET);
      HAL_ADC_Start(&hadc1);
      if (HAL_ADC_PollForConversion(&hadc1, 2) == HAL_OK) {
          vref_adc = HAL_ADC_GetValue(&hadc1);
          if (vref_adc < vr_min) vr_min = vref_adc;
          if (vref_adc > vr_max) vr_max = vref_adc;
          if (vref_adc > 0)
              vdda_mv = __HAL_ADC_CALC_VREFANALOG_VOLTAGE(vref_adc, ADC_RESOLUTION_12B);
      }
      /* PA6 nfault ADC2 */
      HAL_ADC_Start(&hadc2);
      adc_st = HAL_ADC_PollForConversion(&hadc2, 2);
      if (adc_st == HAL_OK) nf_adc = HAL_ADC_GetValue(&hadc2);

      /* AS5047P spi2 half duplex receive */
      /*
      raw = enc_frame();
      reads++;
      if (__builtin_parity(raw))      par_err++;
      else if (raw & 0x4000)          ef_cnt++;
      else {
          ang = raw & 0x3FFF;
          if (ang < amin) amin = ang;
          if (ang > amax) amax = ang;
      }
      */

      /* Encoder align */
      /*

      float mech = ang * (360.0f / 16384.0f);
      float raw_e = fmodf(mech * pole_pairs, 360.0f);
      if (align_req && pwm_run) { e_off = raw_e; align_req = 0; }
      e_deg = raw_e - e_off;
      if (e_deg < 0.0f) e_deg += 360.0f;
      */
      e_err = fmodf(e_deg - ol_deg + 540.0f, 360.0f) - 180.0f;   /* -180..+180 */

      /* FDCAN counter
      static uint32_t tc = 0;
      if (HAL_GetTick() - tc >= 100) {
          tc = HAL_GetTick();
          txd[0] = (uint8_t)can_tx; //counter
          if (HAL_FDCAN_AddMessageToTxFifoQ(&hfdcan1, &txh, txd) == HAL_OK) can_tx++;
          else can_txerr++;
      }
      */

      /* bus health */
      FDCAN_ErrorCountersTypeDef ec;
      FDCAN_ProtocolStatusTypeDef ps;
      HAL_FDCAN_GetErrorCounters(&hfdcan1, &ec);
      HAL_FDCAN_GetProtocolStatus(&hfdcan1, &ps);
      can_tec = ec.TxErrorCnt;  can_rec = ec.RxErrorCnt;  can_busoff = ps.BusOff;

      /* Initial boot */

      static uint8_t boot_cal = 0;
      if (!boot_cal && HAL_GetTick() > 1000) {     /* 1 s after reset */
          boot_cal = 1;
          foc_mode = 0; ol_mode = 1; ol_v = 0.0f;
          cal_req = 1; pwm_ms = 200; pwm_on = 1;
      }
      static uint8_t boot_ms = 0;
      if (boot_cal && !boot_ms && !pwm_run && !cal_req) {
          boot_ms = 1; pwm_ms = 2000; /* restore normal run length on boot */
      }

      /* PWM */

      if (pwm_ms > 60000) pwm_ms = 60000;   /*60s limit*/

      uint32_t arr = __HAL_TIM_GET_AUTORELOAD(&htim1);

      if (!foc_mode) {
      if (ol_mode) {
          if (ol_v > 0.3f) ol_v = 0.3f;  /* open loop limit: 3A */
          float k = arr / 12.0f;
          if (pwm_run) ol_deg += ol_rate;
          if (ol_deg >= 360.0f) ol_deg -= 360.0f;
          if (ol_deg < 0.0f)    ol_deg += 360.0f;
          float th = ol_deg * 0.0174533f;
          float b  = arr / 2.0f;
          __HAL_TIM_SET_COMPARE(&htim1, TIM_CHANNEL_1, (uint32_t)(b + ol_v * k * cosf(th)));
          __HAL_TIM_SET_COMPARE(&htim1, TIM_CHANNEL_2, (uint32_t)(b + ol_v * k * cosf(th - 2.0944f)));
          __HAL_TIM_SET_COMPARE(&htim1, TIM_CHANNEL_3, (uint32_t)(b + ol_v * k * cosf(th + 2.0944f)));
      } else {
          for (int i = 0; i < 3; i++) if (duty[i] > 100) duty[i] = 100;
          __HAL_TIM_SET_COMPARE(&htim1, TIM_CHANNEL_1, duty[0] * arr / 100);
          __HAL_TIM_SET_COMPARE(&htim1, TIM_CHANNEL_2, duty[1] * arr / 100);
          __HAL_TIM_SET_COMPARE(&htim1, TIM_CHANNEL_3, duty[2] * arr / 100);
      }
      }

      /* CAN*/
      static uint32_t t_on = 0;
      static uint8_t was_can = 0;
      uint32_t lc = last_cmd_ms;
      if (can_en && (HAL_GetTick() - lc > 100)) { /* 100 ms timeout */
                can_en = 0; can_timeout_cnt++;
            }
      if (can_en) {
          pwm_run = foc_fault ? 0 : 1; /* CAN in control */
      } else {
          if (was_can) pwm_run = 0; /* CAN stopped */
          if (pwm_on) { pwm_on = 0; if (!foc_fault) { pwm_run = 1; t_on = HAL_GetTick(); } }
          if (pwm_run && (HAL_GetTick() - t_on >= pwm_ms)) pwm_run = 0;
          uint32_t lp = last_param_ms;
          if (keepalive && pwm_run && !cal_req && (HAL_GetTick() - lp > 1000))
                        pwm_run = 0;
      }
      was_can = can_en;

      if (drv_on && pwm_run) __HAL_TIM_MOE_ENABLE(&htim1);
      else                   __HAL_TIM_MOE_DISABLE_UNCONDITIONALLY(&htim1);

      /* PB11 blink */
      static uint32_t t = 0;
      if (HAL_GetTick() - t >= 500) {
          t = HAL_GetTick();
          HAL_GPIO_TogglePin(TOGGLE_GPIO_Port, TOGGLE_Pin);
      }

      HAL_Delay(1);
    }
  /* USER CODE END 3 */
}

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
/* USER CODE BEGIN 4 */

enum { VT_F = 0, VT_U = 1, VT_I = 2 };
typedef struct { volatile void *p; uint8_t type; uint8_t rw; } var_t;

static const var_t vars[] = {
    /*  0 */ { &drv_on,          VT_U, 1 },
    /*  1 */ { &pwm_on,          VT_U, 1 },
    /*  2 */ { &pwm_ms,          VT_U, 1 },
    /*  3 */ { &pwm_run,         VT_U, 0 },
    /*  4 */ { &foc_mode,        VT_U, 1 },
    /*  5 */ { &ctrl_mode,       VT_U, 1 },
    /*  6 */ { &ol_mode,         VT_U, 1 },
    /*  7 */ { &ol_v,            VT_F, 1 },
    /*  8 */ { &ol_deg,          VT_F, 1 },
    /*  9 */ { &ol_rate,         VT_F, 1 },
    /* 10 */ { &cal_req,         VT_U, 1 },
    /* 11 */ { &align_req,       VT_U, 1 },
    /* 12 */ { &save_req,        VT_U, 1 },
    /* 13 */ { &save_res,        VT_I, 0 },
    /* 14 */ { &cal_ok,          VT_U, 0 },
    /* 15 */ { &zero_req,        VT_U, 1 },
    /* 16 */ { &foc_fault,       VT_U, 1 },
    /* 17 */ { &id_ref,          VT_F, 1 },
    /* 18 */ { &iq_ref,          VT_F, 1 },
    /* 19 */ { &i_max,           VT_F, 1 },
    /* 20 */ { &i_trip,          VT_F, 1 },
    /* 21 */ { &kp,              VT_F, 1 },
    /* 22 */ { &ki_ts,           VT_F, 1 },
    /* 23 */ { &vel_ref,         VT_F, 1 },
    /* 24 */ { &vel_kp,          VT_F, 1 },
    /* 25 */ { &vel_ki,          VT_F, 1 },
    /* 26 */ { &p_ref,           VT_F, 1 },
    /* 27 */ { &v_ff,            VT_F, 1 },
    /* 28 */ { &t_ff,            VT_F, 1 },
    /* 29 */ { &kp_p,            VT_F, 1 },
    /* 30 */ { &kd_p,            VT_F, 1 },
    /* 31 */ { &e_off,           VT_F, 1 },
    /* 32 */ { &pole_pairs,      VT_F, 1 },
    /* 33 */ { &id,              VT_F, 0 },
    /* 34 */ { &iq,              VT_F, 0 },
    /* 35 */ { &vd,              VT_F, 0 },
    /* 36 */ { &vq,              VT_F, 0 },
    /* 37 */ { &ia,              VT_F, 0 },
    /* 38 */ { &ib,              VT_F, 0 },
    /* 39 */ { &ic,              VT_F, 0 },
    /* 40 */ { &e_deg,           VT_F, 0 },
    /* 41 */ { &p_rel,           VT_F, 0 },
    /* 42 */ { &vel,             VT_F, 0 },
    /* 43 */ { &off[0],          VT_I, 0 },
    /* 44 */ { &off[1],          VT_I, 0 },
    /* 45 */ { &off[2],          VT_I, 0 },
    /* 46 */ { &isr_cycles,      VT_U, 0 },
    /* 47 */ { &nf_adc,          VT_U, 0 },
    /* 48 */ { &vdda_mv,         VT_U, 0 },
    /* 49 */ { &par_err,         VT_U, 0 },
    /* 50 */ { &ef_cnt,          VT_U, 0 },
    /* 51 */ { &can_timeout_cnt, VT_U, 0 },
	/* 52 */ { &ang32,           VT_U, 0 },
	/* 53 */ { &rst_csr,         VT_U, 0 },
};
#define NVARS ((uint8_t)(sizeof(vars) / sizeof(vars[0])))

static void param_req(const uint8_t *d)
{
	last_param_ms = HAL_GetTick();
    FDCAN_TxHeaderTypeDef th = txh;
    th.Identifier = 0x580 + NODE_ID;
    th.DataLength = FDCAN_DLC_BYTES_8;

    uint8_t r[8] = { 0 };
    uint8_t op = d[0], idx = d[1];
    r[1] = idx;

    if (op == 3) {                                    /* count */
        r[0] = 0x83;
        r[4] = NVARS;
    } else if ((op != 1 && op != 2) || idx >= NVARS) {
        r[0] = 0xFF;                                  /* bad request */
    } else {
        const var_t *v = &vars[idx];
        if (op == 2 && !v->rw) {
            r[0] = 0xFE;                              /* read-only */
        } else {
            if (op == 2) {                            /* single 32-bit store: atomic */
                uint32_t in;
                memcpy(&in, &d[4], 4);
                *(volatile uint32_t *)v->p = in;
            }
            uint32_t out = *(volatile uint32_t *)v->p;
            r[0] = op | 0x80;
            r[2] = v->type;
            memcpy(&r[4], &out, 4);
        }
    }
    HAL_FDCAN_AddMessageToTxFifoQ(&hfdcan1, &th, r);
}

static void send_reply(void)
{
    FDCAN_TxHeaderTypeDef th = txh;
    th.Identifier = 0x100 + NODE_ID;
    th.DataLength = FDCAN_DLC_BYTES_8;
    uint32_t p = f2u(p_rel, -P_MAX, P_MAX, 16);
    uint32_t v = f2u(vel,   -V_MAX, V_MAX, 12);
    uint32_t t = f2u(iq * kt, -T_MAX, T_MAX, 12);
    uint8_t r[8] = { NODE_ID, p >> 8, p & 0xFF, v >> 4,
                     ((v & 0xF) << 4) | (t >> 8), t & 0xFF,
                     (can_en ? 1 : 0) | (foc_fault ? 2 : 0), 0 };
    HAL_FDCAN_AddMessageToTxFifoQ(&hfdcan1, &th, r);
}

void HAL_FDCAN_RxFifo0Callback(FDCAN_HandleTypeDef *h, uint32_t its)
{
    if (!(its & FDCAN_IT_RX_FIFO0_NEW_MESSAGE)) return;
    FDCAN_RxHeaderTypeDef rh;
    uint8_t d[8];
    while (HAL_FDCAN_GetRxMessage(h, FDCAN_RX_FIFO0, &rh, d) == HAL_OK) {
        can_rx++;  can_rxid = rh.Identifier;
        if (rh.Identifier == 0x600 + NODE_ID && rh.DataLength == FDCAN_DLC_BYTES_8) {
                    param_req(d);
                    continue;
                }
        if (rh.Identifier != NODE_ID || rh.DataLength != FDCAN_DLC_BYTES_8) continue;

        if (d[0]==0xFF && d[1]==0xFF && d[2]==0xFF && d[3]==0xFF &&
            d[4]==0xFF && d[5]==0xFF && d[6]==0xFF) {           /* special */
            switch (d[7]) {
            case 0xFC:                                         /* enable */
                if (!foc_fault && !cal_req) {
                    foc_mode = 1; ctrl_mode = 2;
                    last_cmd_ms = HAL_GetTick(); can_en = 1;
                }
                break;
            case 0xFD: can_en = 0; break;                      /* disable */
            case 0xFE: if (!pwm_run) zero_req = 1; break;      /* zero */
            case 0xFB: if (!pwm_run) foc_fault = 0; break;     /* clear fault */
            }
            send_reply();
            continue;
        }
        uint32_t p  = (d[0] << 8) | d[1];
        uint32_t v  = (d[2] << 4) | (d[3] >> 4);
        uint32_t kp = ((d[3] & 0xF) << 8) | d[4];
        uint32_t kd = (d[5] << 4) | (d[6] >> 4);
        uint32_t t  = ((d[6] & 0xF) << 8) | d[7];
        if (can_en) {
            p_ref = u2f(p,  -P_MAX, P_MAX, 16);
            v_ff  = u2f(v,  -V_MAX, V_MAX, 12);
            kp_p  = u2f(kp, 0.0f, KP_MAX, 12);
            kd_p  = u2f(kd, 0.0f, KD_MAX, 12);
            t_ff  = u2f(t,  -T_MAX, T_MAX, 12);
            last_cmd_ms = HAL_GetTick();
            can_cmd_cnt++;
        }
        send_reply();
    }
}

void HAL_ADCEx_InjectedConvCpltCallback(ADC_HandleTypeDef *h)
{
    if (h->Instance != ADC1) return;
    uint32_t t0 = DWT->CYCCNT;

    /* --- currents --- */
    int32_t a = HAL_ADCEx_InjectedGetValue(h, ADC_INJECTED_RANK_1);
    int32_t b = HAL_ADCEx_InjectedGetValue(h, ADC_INJECTED_RANK_2);
    int32_t c = HAL_ADCEx_InjectedGetValue(h, ADC_INJECTED_RANK_3);
    so[0] = a; so[1] = b; so[2] = c;

    static int32_t sa, sb, sc, n;
    if (cal_req && pwm_run && ol_mode && !foc_mode && ol_v == 0.0f) {
        sa += a; sb += b; sc += c;
        if (++n == 1024) {
            off[0] = sa / 1024; off[1] = sb / 1024; off[2] = sc / 1024;
            sa = sb = sc = n = 0; cal_req = 0;
        }
    }
    ia = (a - off[0]) * A_PER_COUNT;
    ib = (b - off[1]) * A_PER_COUNT;
    ic = (c - off[2]) * A_PER_COUNT;
    isum = ia + ib + ic;

    /* --- encoder (moved here from the main loop) --- */
    raw = enc_frame();
    reads++;
    if (__builtin_parity(raw))      par_err++;
    else if (raw & 0x4000)          ef_cnt++;
    else                            ang = raw & 0x3FFF;
    ang32 = ang;
    float mech  = ang * (360.0f / 16384.0f);
    float raw_e = fmodf(mech * pole_pairs, 360.0f);
    if (align_req && pwm_run) { e_off = raw_e; align_req = 0; }
    e_deg = raw_e - e_off;
    if (e_deg < 0.0f) e_deg += 360.0f;

    /* --- multi-turn position + PLL speed estimate --- */
    const float TS = 50e-6f, CNT2RAD = 6.2831853f / 16384.0f;
    static int32_t last_ang = -1, pos_cnt = 0;
    static float pos_est = 0.0f, vel_est = 0.0f;
    if (last_ang < 0) { last_ang = ang; }
    int32_t dcnt = (int32_t)ang - last_ang;
    if (dcnt >  8192) dcnt -= 16384;
    if (dcnt < -8192) dcnt += 16384;
    last_ang = ang;
    pos_cnt += dcnt;
    float pos_meas = pos_cnt * CNT2RAD;

    float perr = pos_meas - pos_est;
    pos_est += TS * (vel_est + 2.0f * pll_bw * perr);
    vel_est += TS * (pll_bw * pll_bw * perr);
    pos = pos_meas;  vel = vel_est;  rpm = vel_est * 9.5493f;

    if (zero_req) { pos_zero = pos_meas; zero_req = 0; }
    p_rel = pos_meas - pos_zero;
    if (!pwm_run) p_ref = p_rel;       /* idle: target follows the rotor */

    /* --- overspeed trip --- */
    if (pwm_run && fabsf(vel_est) > vel_trip) {
        __HAL_TIM_MOE_DISABLE_UNCONDITIONALLY(&htim1);
        pwm_run = 0; foc_fault = 2;
    }

    /* --- velocity loop -> iq command --- */
    static float vel_int = 0.0f;
    if (foc_mode && pwm_run && ctrl_mode == 1) {            /* velocity */
        float ve = vel_ref - vel_est;
        vel_int = fminf(fmaxf(vel_int + vel_ki * ve * TS, -i_max), i_max);
        iq_cmd  = fminf(fmaxf(vel_kp * ve + vel_int, -i_max), i_max);
    } else if (foc_mode && pwm_run && ctrl_mode == 2) {     /* impedance */
        vel_int = 0.0f;
        float tq = kp_p * (p_ref - p_rel) + kd_p * (v_ff - vel_est) + t_ff;
        torque_cmd = tq;
        iq_cmd = fminf(fmaxf(tq / kt, -i_max), i_max);
    } else {                                                /* direct iq */
        vel_int = 0.0f;
        iq_cmd  = iq_ref;
    }

    /* --- hard overcurrent trip --- */
    if (pwm_run && drv_on && !cal_req &&
            (fabsf(ia) > i_trip || fabsf(ib) > i_trip || fabsf(ic) > i_trip)) {
        __HAL_TIM_MOE_DISABLE_UNCONDITIONALLY(&htim1);
        pwm_run = 0; foc_fault = 1;
    }

    /* --- current loop --- */
    static float id_int = 0.0f, iq_int = 0.0f;
    if (foc_mode && pwm_run) {
        float th = e_deg * 0.0174533f, s = sinf(th), co = cosf(th);

        float ial = ia;                              /* Clarke */
        float ibe = (ia + 2.0f * ib) * 0.57735f;
        id =  ial * co + ibe * s;                    /* Park */
        iq = -ial * s  + ibe * co;

        float idr = fminf(fmaxf(id_ref, -i_max), i_max);
        float iqr = fminf(fmaxf(iq_cmd, -i_max), i_max);
        float vlim = 0.9f * VBUS * 0.57735f;

        float ed = idr - id, eq = iqr - iq;          /* PI */
        id_int = fminf(fmaxf(id_int + ki_ts * ed, -vlim), vlim);
        iq_int = fminf(fmaxf(iq_int + ki_ts * eq, -vlim), vlim);
        float vdd = kp * ed + id_int, vqq = kp * eq + iq_int;
        float vm = sqrtf(vdd * vdd + vqq * vqq);
        if (vm > vlim) { vdd *= vlim / vm; vqq *= vlim / vm; }
        vd = vdd; vq = vqq;

        float val = vdd * co - vqq * s;              /* inverse Park */
        float vbe = vdd * s  + vqq * co;
        float Va = val;                              /* inverse Clarke */
        float Vb = -0.5f * val + 0.866025f * vbe;
        float Vc = -0.5f * val - 0.866025f * vbe;
        float vo = 0.5f * (fmaxf(Va, fmaxf(Vb, Vc)) + fminf(Va, fminf(Vb, Vc)));

        uint32_t arr = __HAL_TIM_GET_AUTORELOAD(&htim1);
        float k = arr / VBUS, mid = arr * 0.5f;
        __HAL_TIM_SET_COMPARE(&htim1, TIM_CHANNEL_1, (uint32_t)(mid + (Va - vo) * k));
        __HAL_TIM_SET_COMPARE(&htim1, TIM_CHANNEL_2, (uint32_t)(mid + (Vb - vo) * k));
        __HAL_TIM_SET_COMPARE(&htim1, TIM_CHANNEL_3, (uint32_t)(mid + (Vc - vo) * k));
    } else {
        id_int = iq_int = 0.0f;                      /* reset when not running */
    }

    isr_cycles = DWT->CYCCNT - t0;
    isr_cnt++;
}

/* USER CODE END 4 */
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
