qyugo/YVGESC/firmware/1p0/yvgesc-v1p0.ioc

Mcu.UserName=STM32G431RBTx
PA0.Signal=ADC1_IN1
PA1.Signal=ADC1_IN2
PA10.Signal=S_TIM1_CH3
PA13.Signal=SYS_JTMS-SWDIO
PA14.Signal=SYS_JTCK-SWCLK
PA2.Signal=ADC1_IN3
PA6.Signal=ADC2_IN3
PA7.Signal=TIM1_CH1N
PA8.Signal=S_TIM1_CH1
PA9.Signal=S_TIM1_CH2
PB0.Signal=TIM1_CH2N
PB1.Signal=TIM1_CH3N
PB11.GPIO_Label=TOGGLE
PB11.Signal=GPIO_Output
PB12.GPIO_Label=ENC_CS
PB12.Signal=GPIO_Output
PB13.Signal=SPI2_SCK
PB14.GPIO_Label=ENC_MOSI_HI
PB14.Signal=GPIO_Output
PB15.Signal=SPI2_MOSI
PB8-BOOT0.Signal=FDCAN1_RX
PB9.Signal=FDCAN1_TX
PC0.GPIO_Label=DRV_EN
PC0.Signal=GPIO_Output
PC1.GPIO_Label=DRV_CAL
PC1.Signal=GPIO_Output
PF0-OSC_IN.Signal=RCC_OSC_IN
PF1-OSC_OUT.Signal=RCC_OSC_OUT
