qyugo/YVGESC/firmware/1p0/Core/Inc/main.h

#define DRV_EN_Pin GPIO_PIN_0
#define DRV_EN_GPIO_Port GPIOC
#define DRV_CAL_Pin GPIO_PIN_1
#define DRV_CAL_GPIO_Port GPIOC
#define TOGGLE_Pin GPIO_PIN_11
#define TOGGLE_GPIO_Port GPIOB
#define ENC_CS_Pin GPIO_PIN_12
#define ENC_CS_GPIO_Port GPIOB
#define ENC_MOSI_HI_Pin GPIO_PIN_14
#define ENC_MOSI_HI_GPIO_Port GPIOB
