qyugo/YVGESC/(commit log)

2026-09-02 PCB Schematics
2026-09-02 Create kicad-images
2026-09-02 add schematics
2026-09-05 add bom
    [yvgesc1-electricalcomponents-bom.xlsx]
2026-09-20 Update Mechanical-Setup.md
    Updated the Mechanical Setup instructions for clarity and added details on mounting and heatsinking recommendations.
2026-09-20 Revise Electrical and STM32 Hardware Setup documentation
    Updated Electrical Setup and STM32 Hardware Setup sections with additional details and formatting improvements.
2026-09-29 Update README.md
    Adjusted image width for driver boards in README.
2026-09-29 Create README.md for hardware design documentation
    Added documentation for hardware design including schematics and components.
2026-09-29 Create schematic.md for YVGESC-1
    Add schematic documentation for YVGESC-1 designed in KiCad.
2026-09-29 Update schematic download links and iframe source
2026-09-29 Change iframe source for schematic display
    Updated iframe source link for the schematic.
2026-09-29 Update schematic download link and iframe source
2026-09-29 Revise download link text in schematic documentation
    Updated download link text for clarity.
2026-09-30 Rename title and add PCB Routing section
    Updated the title from 'Schematic' to 'Schematics' and added a new section for PCB Routing with images and a link to the PCB layout.
2026-09-30 Update bom.md
    Added metadata for navigation and title to BOM document.
2026-09-30 Rename title from 'Schematics' to 'Bill of Materials'
2026-09-30 Update schematic.md
    Added iframe elements for schematic and PCB layout images.
2026-09-30 Update README.md
    Updated the README to clarify features and specifications of the YVGESC, including details on the board size, current ratings, and communication options.
2026-09-30 Update Firmware-Setup.md
    Updated the firmware setup instructions for STM32G, including hardware and software setup details.
2026-09-30 Revise Firmware Setup instructions for Nucleo-G431RB
    Updated the firmware setup instructions for the Nucleo-G431RB board, including detailed steps for ST-Link configuration and jumper settings.
2026-10-01 Add README for PB11 blink test setup
    Added detailed instructions for setting up a blink test on PB11 pin using STM32CubeMX, including configuration for the oscillator and DRV_ENABLE pin.
2026-10-03 Add firmware configuration documentation for v1p0
    Documented firmware configuration and hardware connections for STM32CubeIDE project, including details on AS5047P encoder and gate driver setup.
2026-10-04 1p0 firmware for DRV wakeup/fault, encoder, SPI reconfiguring, and VDDA reconfiguring
    1.0 prerelease firmware for DRV wakeup/fault, encoder, SPI reconfiguring, and VDDA reconfiguring. Some horrible issues that have finally been solved - see Issues maybe tomorrow for doc.
    [main.c, main.h, yvgesc-blink.ioc, yvgesc-v1p0.ioc]
2026-10-04 Add firmware 1.0 documentation
    Added documentation for firmware version 1.0 including details on AS5047, nFAULT LED, and ADC.
2026-10-04 0.2 Firmware - CAN and PWM
    No issues on this one. Didn't test with another can module, so that will have to come later. But self-contained CAN stuff works fine.
    [main.c, main.h, yvgesc-v1p0.ioc]
2026-10-04 Document FDCAN and PWM setup in yvgesc-1p0config.md
    Added sections for FDCAN and PWM configuration with relevant details and images.
2026-10-04 current pi loop firmware + flash script
    V0.3 firmware for closed loop current/torque control. Also an update to flash linker script to store calibration values.
2026-10-05 velocity control firmware
    velocity pi loops with starting kp/ki values
2026-10-06 Update firmware configuration and release versions
    Added updates for ADC, FDCAN, and PWM drive functionalities. Released firmware versions 0.1, 0.2, and 0.4 with detailed calibration and control mechanisms.
2026-10-06 Add documentation for V1 issues of YVGESC
    Document issues found in the first iteration of the YVGESC, including encoder wiring errors and hardware jumper configurations.
2026-10-06 Revise Mechanical Setup instructions and images
    Updated images and added information about mounting and cooling recommendations.
2026-10-06 Document hardware and firmware issues for V1.0
    Added a section for hardware and firmware issues related to board releases, including a link to documentation for V1.0 and a note on potential issues to verify in testing.
2026-10-06 Create README.md for firmware documentation
    Added comprehensive documentation for firmware bring-up, including current status and pre-release versions.
2026-10-06 Update USB power and isolation information in README
    Clarified USB power usage and isolation recommendations.
2026-10-06 Revise firmware documentation for version 1.0
    Updated documentation for firmware version 1.0, including detailed sections on blink configuration, AS5047P encoder setup, gate driver, current sense, FDCAN, PWM, phase current sampling, current loop, torque mode, velocity control, and impedance control.
2026-10-08 Update keepalive condition for PWM control
    Refactor keepalive condition to use last_param_ms variable.
2026-10-08 Refactor velocity control and update calibration notes
    Removed old velocity control variables and added new control logic for impedance mode. Updated calibration and flash storage instructions.
2026-10-14 Update CANSetup.md with configuration details
    Added explanation for CAN setup and termination resistance.
2026-10-14 Create board testing documentation
    Added initial documentation for board testing protocols, including thermal analysis and emissions testing.
