qyugo/YVGESC/(notices)

Notices in the files:
firmware/1p0/Core/Inc/main.h:
Copyright (c) 2026 STMicroelectronics.
All rights reserved.
This software is licensed under terms that can be found in the LICENSE file
